granthaack/Defcon26Badge/pcb_files/BoardFootprintBottom.png

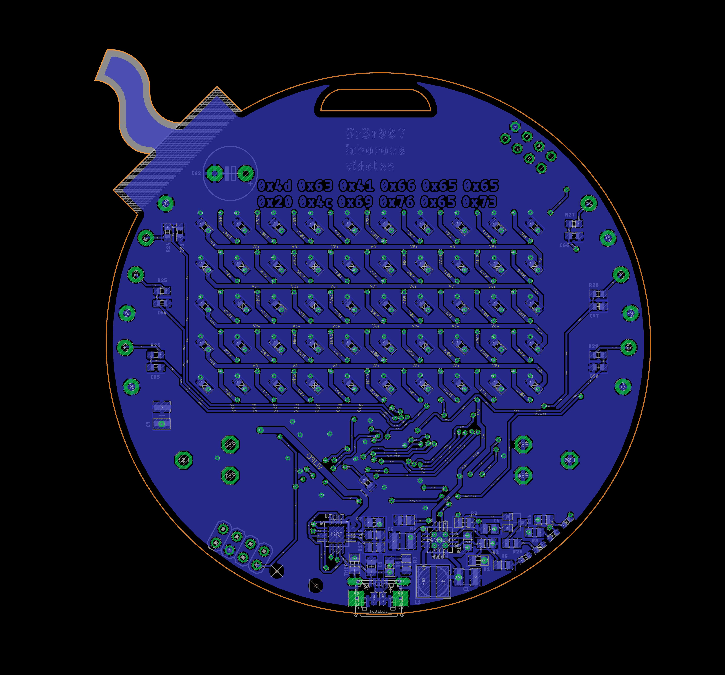
pcb_files/BoardFootprintBottom.png
