granthaack/Defcon26Badge/pcb_files/BoardFootprintTop.png

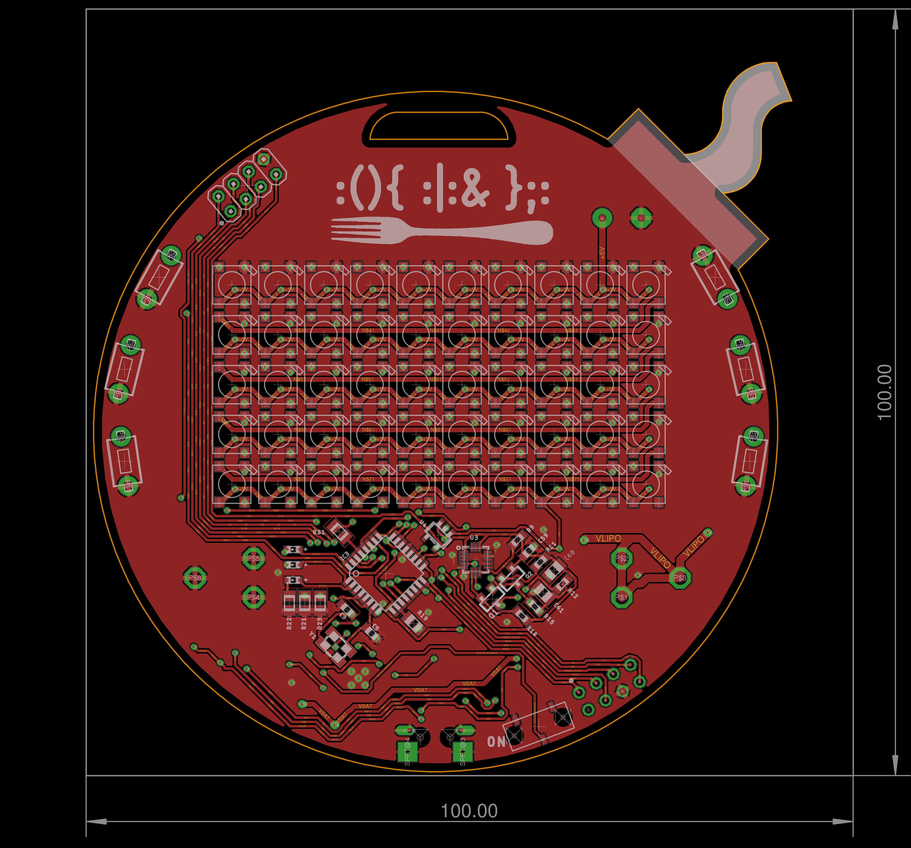
pcb_files/BoardFootprintTop.png
