granthaack/Defcon26Badge/pcb_files/footprint.png

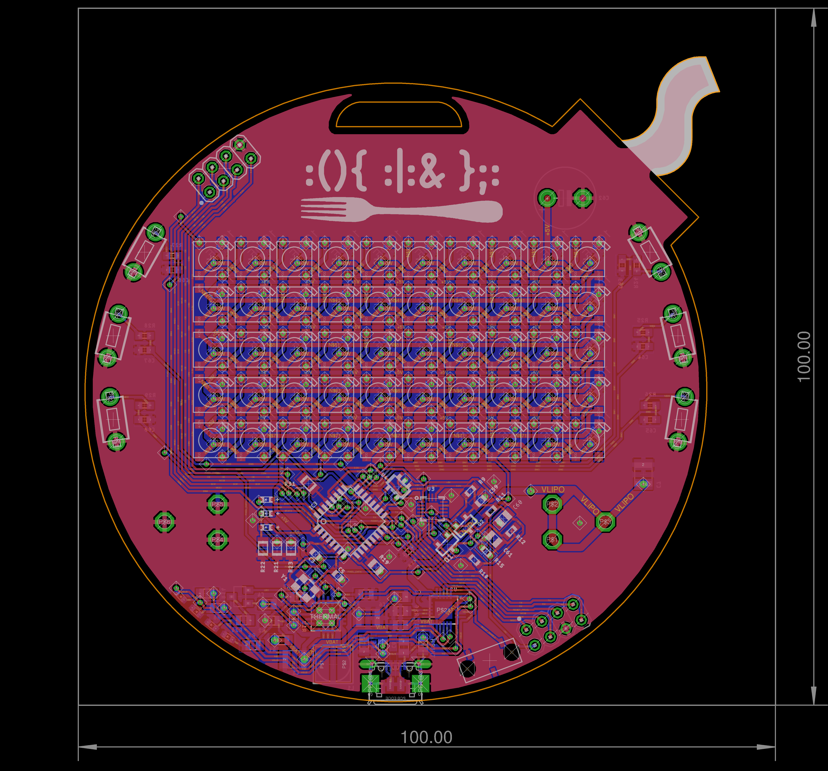
pcb_files/footprint.png
