granthaack/Defcon26Badge/pcb_files/schematic-highres.png

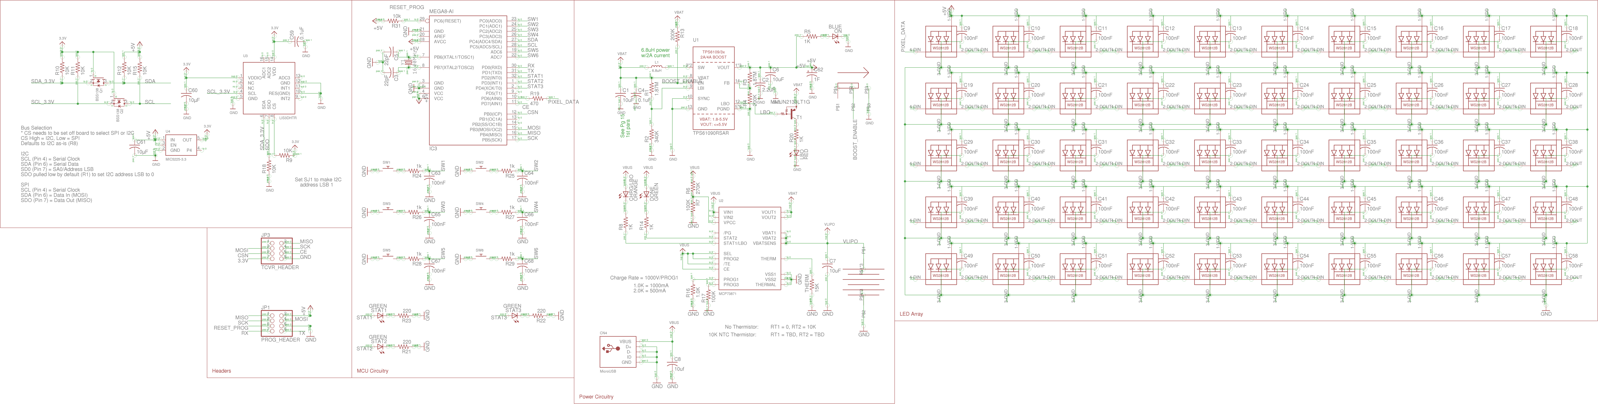
pcb_files/schematic-highres.png
