granthaack/Defcon26Badge/pcb_files/schematic.png

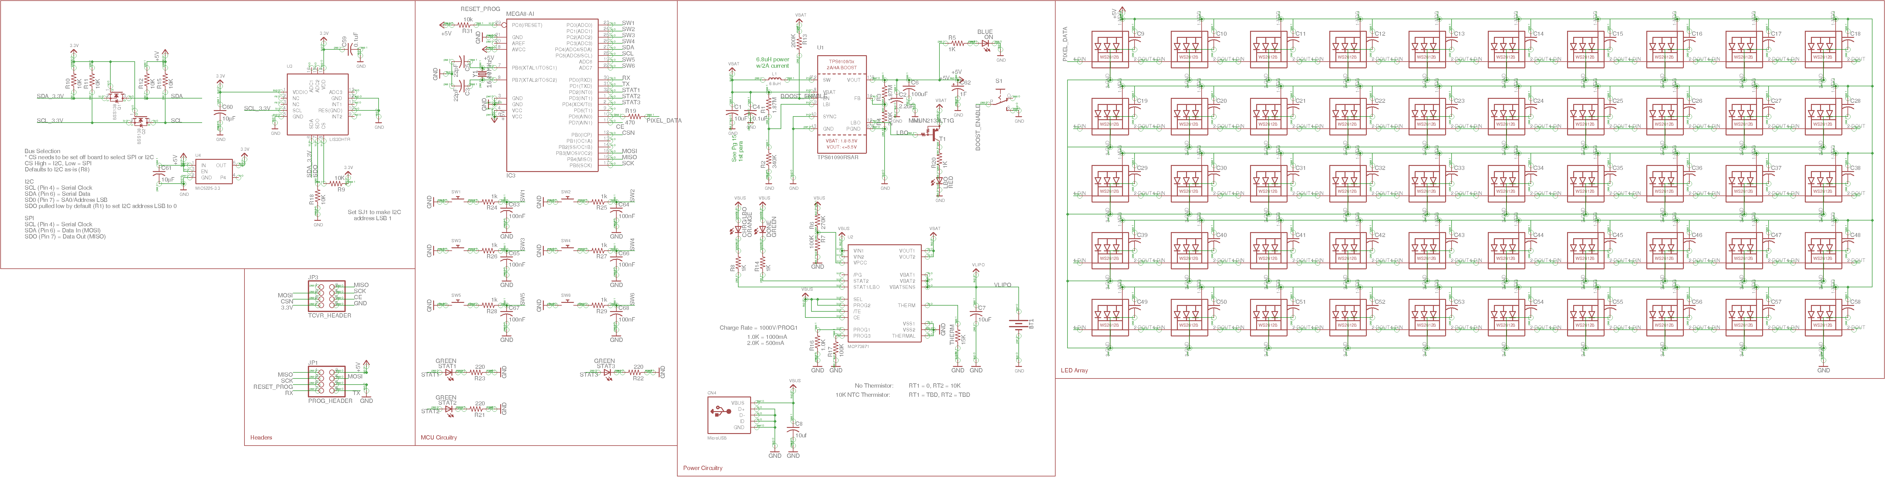
pcb_files/schematic.png
