granthaack/Defcon26Badge/pcb_files/badge.brd

## EAGLE design pcb_files/badge.brd (2018-06-25)

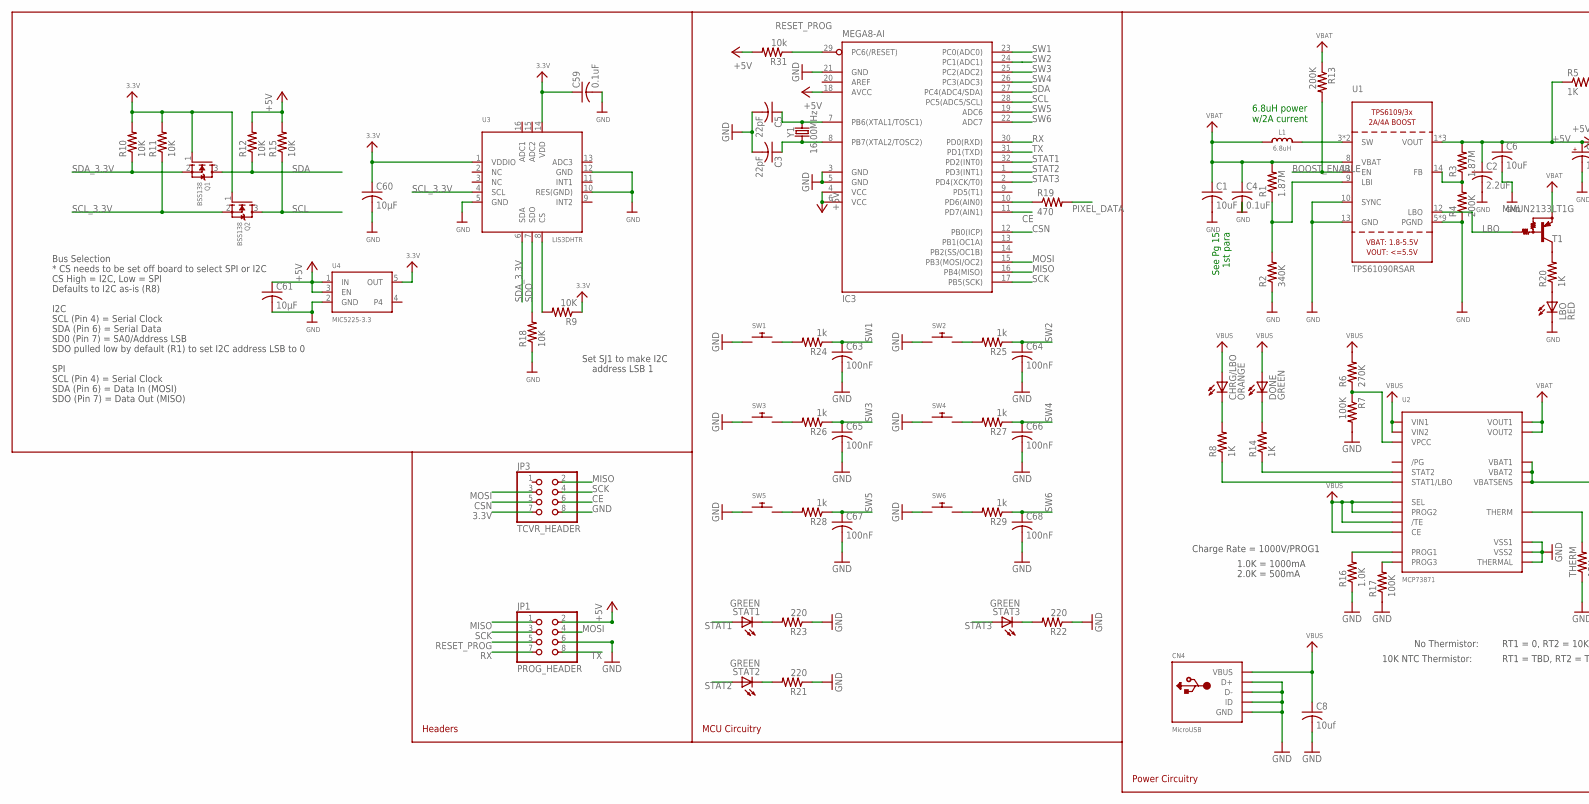
[picture p6: schematic badge.sch, part in row 1, column 1]

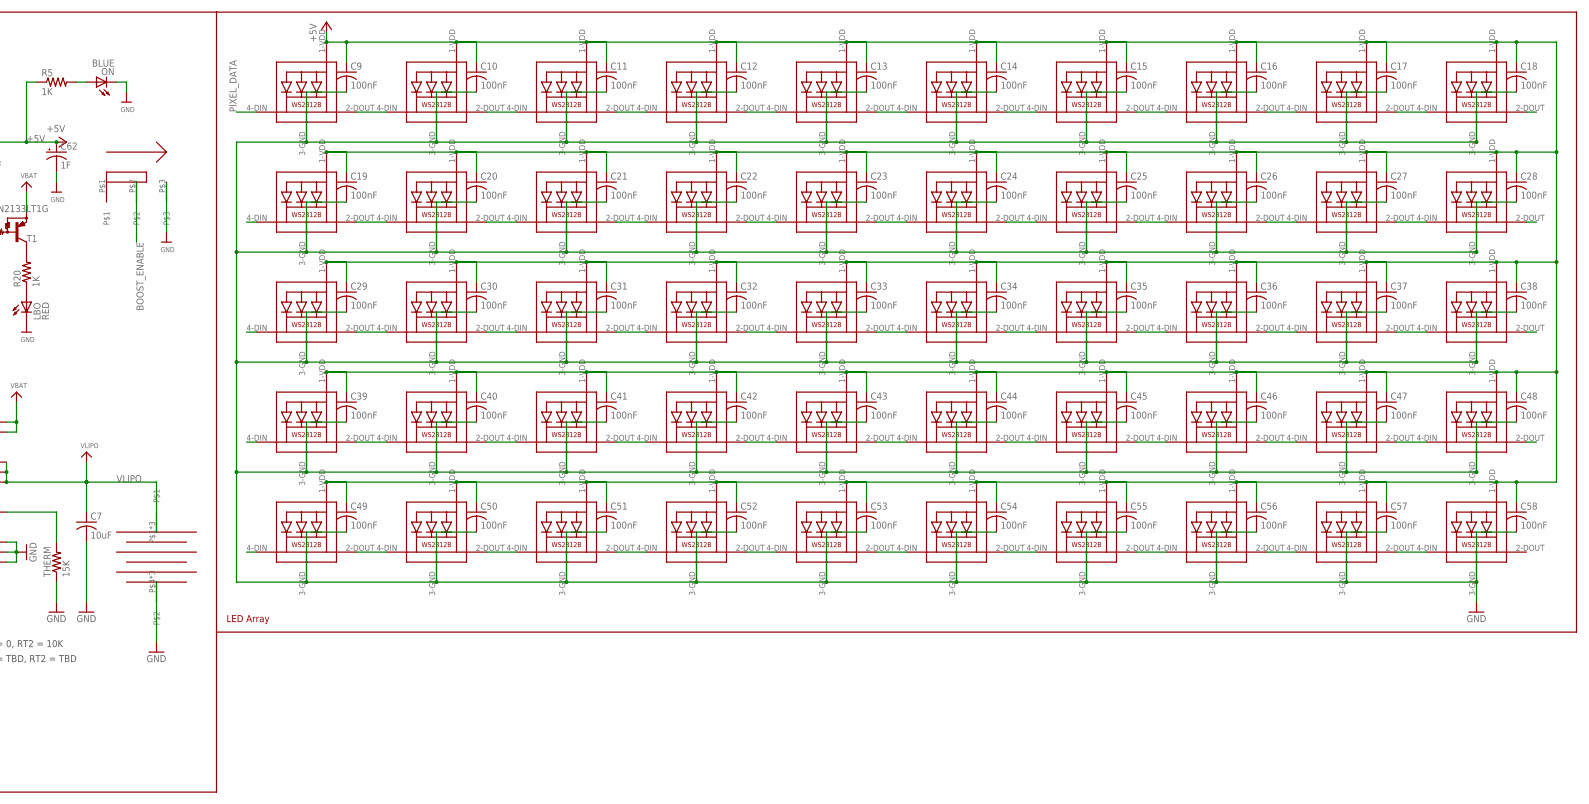
[picture p7: schematic badge.sch, part in row 1, column 2]

Parts:
C1, C6, C7: 10uF; C1210
C2: 2.2uF; C0805
C3, C5: 22pF; C0603
C4: 0.1uF; C0805
C8: 10uf; C0805
C9, C10, C11, C12, C13, C14, C15, C16, C17, C18, C19, C20, C21, C22, C23, C24, C25, C26, C27, C28, C29, C30, C31, C32, C33, C34, C35, C36, C37, C38, C39, C40, C41, C42, C43, C44, C45, C46, C47, C48, C49, C50, C51, C52, C53, C54, C55, C56, C57, C58, C63, C64, C65, C66, C67, C68: 100nF; C0603
C59: 0.1uF; C0603
C60, C61: 10µF; C0805
C62: 1F; E5-8,5
CHRG/LBO: ORANGE; ADAFRUIT_CHIPLED_0603
CN4: MicroUSB; 4UCONN_20329
DONE: GREEN; ADAFRUIT_CHIPLED_0603
IC3: MEGA8-AI; TQFP32-08
JP1: PROG_HEADER; 2X04
JP3: TCVR_HEADER; 2X04
L1: 6.8uH; INDUCTOR_5X5MM_TDK_VLC5045
LBO: RED; ADAFRUIT_CHIPLED_0603
LED1, LED2, LED3, LED4, LED5, LED6, LED7, LED8, LED9, LED10, LED11, LED12, LED13, LED14, LED15, LED16, LED17, LED18, LED19, LED20, LED21, LED22, LED23, LED24, LED25, LED26, LED27, LED28, LED29, LED30, LED31, LED32, LED33, LED34, LED35, LED36, LED37, LED38, LED39, LED40, LED41, LED42, LED43, LED44, LED45, LED46, LED47, LED48, LED49, LED50: WS2812B5050-NARROW; WS2812B-NARROW
ON: BLUE; ADAFRUIT_CHIPLED_0603
Q1, Q2: BSS138; SOT23-WIDE
R1, R3: 1.87M; R0805
R2: 340K; R0805
R4, R13: 200K; R0805
R5, R8, R14, R20: 1K; R0805
R6: 270K; R0805
R7, R17: 100K; R0805
R9, R10, R11, R12, R15, R18: 10K; R0603
R16: 1.0K; R0805
R19: 470; R0805
R21, R22, R23: 220; M0805
R24, R25, R26, R27, R28, R29: 1k; R0603
R31: 10k; M0805
STAT1, STAT2, STAT3: GREEN; ADAFRUIT_CHIPLED_0603
SW1, SW2, SW3, SW4, SW5, SW6: SWITCH_PUSHBUTTONEVQ-PE; TACT_PANA-EVQ
T1: MMUN2133LT1G; TRANSISTOR_SC59-BEC
THERM: 15K; R0805
U1: TPS61090RSAR; PVQFN-16
U2: MCP73871; QFN20_4MM
U3: LIS3DHTR; LGA16_3X3MM
U4: MIC5225-3.3; SOT23-5
U$17: CL-SB-12A-02T
U$22: 54_BATTERY_CLIP
Y1: 16.00MHz; CRYSTAL-SMD-3.2X2.5MM

Connections:
3.3V: C59.1, C60.1, JP3.7, Q1.1 (G), Q2.1 (G), R9.1, R10.2, R11.2, U3.1 (VDDIO), U3.14 (VDD), U4.5 (OUT)
+5V: C2.1, C6.1, C9.1, C10.1, C11.1, C12.1, C13.1, C14.1, C15.1, C16.1, C17.1, C18.1, C19.1, C20.1, C21.1, C22.1, C23.1, C24.1, C25.1, C26.1, C27.1, C28.1, C29.1, C30.1, C31.1, C32.1, C33.1, C34.1, C35.1, C36.1, C37.1, C38.1, C39.1, C40.1, C41.1, C42.1, C43.1, C44.1, C45.1, C46.1, C47.1, C48.1, C49.1, C50.1, C51.1, C52.1, C53.1, C54.1, C55.1, C56.1, C57.1, C58.1, C61.1, C62.+, IC3.4 (VCC), IC3.6 (VCC), IC3.18 (AVCC), JP1.2, LED1.1-VDD (VDD), LED2.1-VDD (VDD), LED3.1-VDD (VDD), LED4.1-VDD (VDD), LED5.1-VDD (VDD), LED6.1-VDD (VDD), LED7.1-VDD (VDD), LED8.1-VDD (VDD), LED9.1-VDD (VDD), LED10.1-VDD (VDD), LED11.1-VDD (VDD), LED12.1-VDD (VDD), LED13.1-VDD (VDD), LED14.1-VDD (VDD), LED15.1-VDD (VDD), LED16.1-VDD (VDD), LED17.1-VDD (VDD), LED18.1-VDD (VDD), LED19.1-VDD (VDD), LED20.1-VDD (VDD), LED21.1-VDD (VDD), LED22.1-VDD (VDD), LED23.1-VDD (VDD), LED24.1-VDD (VDD), LED25.1-VDD (VDD), LED26.1-VDD (VDD), LED27.1-VDD (VDD), LED28.1-VDD (VDD), LED29.1-VDD (VDD), LED30.1-VDD (VDD), LED31.1-VDD (VDD), LED32.1-VDD (VDD), LED33.1-VDD (VDD), LED34.1-VDD (VDD), LED35.1-VDD (VDD), LED36.1-VDD (VDD), LED37.1-VDD (VDD), LED38.1-VDD (VDD), LED39.1-VDD (VDD), LED40.1-VDD (VDD), LED41.1-VDD (VDD), LED42.1-VDD (VDD), LED43.1-VDD (VDD), LED44.1-VDD (VDD), LED45.1-VDD (VDD), LED46.1-VDD (VDD), LED47.1-VDD (VDD), LED48.1-VDD (VDD), LED49.1-VDD (VDD), LED50.1-VDD (VDD), R3.2, R5.1, R12.2, R15.2, R31.2, U1.1 (VOUT), U1.15 (VOUT), U1.16 (VOUT), U4.1 (IN), U4.3 (EN)
BOOST_ENABLE: R13.2, U1.11 (EN), U$17.P$2
CE: IC3.11 (PD7(AIN1)), JP3.6
CSN: IC3.12 (PB0(ICP)), JP3.5
GND: C1.2, C2.2, C3.2, C4.2, C5.2, C6.2, C7.2, C8.2, C9.2, C10.2, C11.2, C12.2, C13.2, C14.2, C15.2, C16.2, C17.2, C18.2, C19.2, C20.2, C21.2, C22.2, C23.2, C24.2, C25.2, C26.2, C27.2, C28.2, C29.2, C30.2, C31.2, C32.2, C33.2, C34.2, C35.2, C36.2, C37.2, C38.2, C39.2, C40.2, C41.2, C42.2, C43.2, C44.2, C45.2, C46.2, C47.2, C48.2, C49.2, C50.2, C51.2, C52.2, C53.2, C54.2, C55.2, C56.2, C57.2, C58.2, C59.2, C60.2, C61.2, C62.-, C63.2, C64.2, C65.2, C66.2, C67.2, C68.2, CN4.BASE@1 (GND), CN4.BASE@2 (GND), CN4.D+, CN4.D-, CN4.GND, CN4.ID, CN4.SPRT@1 (GND), CN4.SPRT@2 (GND), CN4.SPRT@3 (GND), CN4.SPRT@4 (GND), IC3.3 (GND), IC3.5 (GND), IC3.21 (GND), JP1.6, JP3.8, LBO.C, LED1.3-GND (GND), LED2.3-GND (GND), LED3.3-GND (GND), LED4.3-GND (GND), LED5.3-GND (GND), LED6.3-GND (GND), LED7.3-GND (GND), LED8.3-GND (GND), LED9.3-GND (GND), LED10.3-GND (GND), LED11.3-GND (GND), LED12.3-GND (GND), LED13.3-GND (GND), LED14.3-GND (GND), LED15.3-GND (GND), LED16.3-GND (GND), LED17.3-GND (GND), LED18.3-GND (GND), LED19.3-GND (GND), LED20.3-GND (GND), LED21.3-GND (GND), LED22.3-GND (GND), LED23.3-GND (GND), LED24.3-GND (GND), LED25.3-GND (GND), LED26.3-GND (GND), LED27.3-GND (GND), LED28.3-GND (GND), LED29.3-GND (GND), LED30.3-GND (GND), LED31.3-GND (GND), LED32.3-GND (GND), LED33.3-GND (GND), LED34.3-GND (GND), LED35.3-GND (GND), LED36.3-GND (GND), LED37.3-GND (GND), LED38.3-GND (GND), LED39.3-GND (GND), LED40.3-GND (GND), LED41.3-GND (GND), LED42.3-GND (GND), LED43.3-GND (GND), LED44.3-GND (GND), LED45.3-GND (GND), LED46.3-GND (GND), LED47.3-GND (GND), LED48.3-GND (GND), LED49.3-GND (GND), LED50.3-GND (GND), ON.C, R2.1, R4.1, R7.2, R16.1, R17.1, R18.1, R21.1, R22.1, R23.1, SW1.P$1, SW2.P$1, SW3.P$1, SW4.P$1, SW5.P$1, SW6.P$1, THERM.1, U1.5 (PGND), U1.6 (PGND), U1.7 (PGND), U1.10 (SYNC), U1.13 (GND), U1.P$18 (PGND), U1.P$19 (PGND), U1.P$20 (PGND), U1.P$21 (PGND), U1.P$22 (PGND), U1.THERMAL (PGND), U2.P$10 (VSS1), U2.P$11 (VSS2), U2.P$21 (THERMAL), U3.5 (GND), U3.10 (RES(GND)), U3.12 (GND), U4.2 (GND), U$17.P$3, U$22.P$4, U$22.P$5, U$22.P$6
LBO: T1.B, U1.12 (LBO)
MISO: IC3.16 (PB4(MISO)), JP1.1, JP3.2
MOSI: IC3.15 (PB3(MOSI/OC2)), JP1.4, JP3.3
unnamed: L1.P$2 (2), U1.3 (SW), U1.4 (SW)
unnamed: LBO.A, R20.1
unnamed: R1.1, R2.2, U1.9 (LBI)
unnamed: ON.A, R5.2
unnamed: R3.1, R4.2, U1.14 (FB)
unnamed: R20.2, T1.C
unnamed: R6.1, R7.1, U2.P$2 (VPCC)
unnamed: DONE.C, R14.2
unnamed: R14.1, U2.P$7 (STAT2)
unnamed: THERM.2, U2.P$5 (THERM)
unnamed: R8.1, U2.P$8 (STAT1/LBO)
unnamed: CHRG/LBO.C, R8.2
unnamed: R17.2, U2.P$12 (PROG3)
unnamed: C5.1, IC3.7 (PB6(XTAL1/TOSC1)), Y1.3 (2)
unnamed: C3.1, IC3.8 (PB7(XTAL2/TOSC2)), Y1.1
unnamed: R16.2, U2.P$13 (PROG1)
unnamed: LED2.2-DOUT (DO), LED3.4-DIN (DI)
unnamed: R9.2, U3.8 (CS)
unnamed: R21.2, STAT2.C
unnamed: R22.2, STAT3.C
unnamed: R23.2, STAT1.C
unnamed: R24.2, SW1.P$2
unnamed: LED1.2-DOUT (DO), LED2.4-DIN (DI)
unnamed: LED3.2-DOUT (DO), LED4.4-DIN (DI)
unnamed: LED4.2-DOUT (DO), LED5.4-DIN (DI)
unnamed: LED5.2-DOUT (DO), LED6.4-DIN (DI)
unnamed: R26.2, SW3.P$2
unnamed: R28.2, SW5.P$2
unnamed: R29.2, SW6.P$2
unnamed: R27.2, SW4.P$2
unnamed: R25.2, SW2.P$2
unnamed: LED6.2-DOUT (DO), LED7.4-DIN (DI)
unnamed: LED7.2-DOUT (DO), LED8.4-DIN (DI)
unnamed: LED8.2-DOUT (DO), LED9.4-DIN (DI)
unnamed: LED9.2-DOUT (DO), LED10.4-DIN (DI)
unnamed: LED10.2-DOUT (DO), LED11.4-DIN (DI)
unnamed: LED11.2-DOUT (DO), LED12.4-DIN (DI)
unnamed: LED12.2-DOUT (DO), LED13.4-DIN (DI)
unnamed: LED13.2-DOUT (DO), LED14.4-DIN (DI)
unnamed: LED14.2-DOUT (DO), LED15.4-DIN (DI)
unnamed: LED15.2-DOUT (DO), LED16.4-DIN (DI)
unnamed: LED16.2-DOUT (DO), LED17.4-DIN (DI)
unnamed: LED17.2-DOUT (DO), LED18.4-DIN (DI)
unnamed: LED18.2-DOUT (DO), LED19.4-DIN (DI)
unnamed: LED19.2-DOUT (DO), LED20.4-DIN (DI)
unnamed: LED20.2-DOUT (DO), LED21.4-DIN (DI)
unnamed: LED21.2-DOUT (DO), LED22.4-DIN (DI)
unnamed: LED22.2-DOUT (DO), LED23.4-DIN (DI)
unnamed: LED23.2-DOUT (DO), LED24.4-DIN (DI)
unnamed: LED24.2-DOUT (DO), LED25.4-DIN (DI)
unnamed: LED25.2-DOUT (DO), LED26.4-DIN (DI)
unnamed: LED26.2-DOUT (DO), LED27.4-DIN (DI)
unnamed: LED27.2-DOUT (DO), LED28.4-DIN (DI)
unnamed: LED28.2-DOUT (DO), LED29.4-DIN (DI)
unnamed: LED29.2-DOUT (DO), LED30.4-DIN (DI)
unnamed: LED30.2-DOUT (DO), LED31.4-DIN (DI)
unnamed: LED31.2-DOUT (DO), LED32.4-DIN (DI)
unnamed: LED32.2-DOUT (DO), LED33.4-DIN (DI)
unnamed: LED33.2-DOUT (DO), LED34.4-DIN (DI)
unnamed: LED34.2-DOUT (DO), LED35.4-DIN (DI)
unnamed: LED35.2-DOUT (DO), LED36.4-DIN (DI)
unnamed: LED36.2-DOUT (DO), LED37.4-DIN (DI)
unnamed: LED37.2-DOUT (DO), LED38.4-DIN (DI)
unnamed: LED38.2-DOUT (DO), LED39.4-DIN (DI)
unnamed: LED39.2-DOUT (DO), LED40.4-DIN (DI)
unnamed: LED40.2-DOUT (DO), LED41.4-DIN (DI)
unnamed: LED41.2-DOUT (DO), LED42.4-DIN (DI)
unnamed: LED42.2-DOUT (DO), LED43.4-DIN (DI)
unnamed: LED43.2-DOUT (DO), LED44.4-DIN (DI)
unnamed: LED44.2-DOUT (DO), LED45.4-DIN (DI)
unnamed: LED45.2-DOUT (DO), LED46.4-DIN (DI)
unnamed: LED46.2-DOUT (DO), LED47.4-DIN (DI)
unnamed: LED47.2-DOUT (DO), LED48.4-DIN (DI)
unnamed: LED48.2-DOUT (DO), LED49.4-DIN (DI)
unnamed: LED49.2-DOUT (DO), LED50.4-DIN (DI)
NEO-DOUT: IC3.10 (PD6(AIN0)), R19.1
PIXEL_DATA: LED1.4-DIN (DI), R19.2
RESET_PROG: IC3.29 (PC6(/RESET)), JP1.5, R31.1
RX: IC3.30 (PD0(RXD)), JP1.7
SCK: IC3.17 (PB5(SCK)), JP1.3, JP3.4
SCL: IC3.28 (PC5(ADC5/SCL)), Q2.3 (D), R15.1
SCL_3.3V: Q2.2 (S), R11.1, U3.4 (SCL)
SDA: IC3.27 (PC4(ADC4/SDA)), Q1.3 (D), R12.1
SDA_3.3V: Q1.2 (S), R10.1, U3.6 (SDA)
SDO: R18.2, U3.7 (SDO)
STAT1: IC3.32 (PD2(INT0)), STAT1.A
STAT2: IC3.1 (PD3(INT1)), STAT2.A
STAT3: IC3.2 (PD4(XCK/T0)), STAT3.A
SW1: C63.1, IC3.23 (PC0(ADC0)), R24.1
SW2: C64.1, IC3.24 (PC1(ADC1)), R25.1
SW3: C65.1, IC3.25 (PC2(ADC2)), R26.1
SW4: C66.1, IC3.26 (PC3(ADC3)), R27.1
SW5: C67.1, IC3.19 (ADC6), R28.1
SW6: C68.1, IC3.22 (ADC7), R29.1
TX: IC3.31 (PD1(TXD)), JP1.8
VBAT: C1.1, C4.1, L1.P$1 (1), R1.2, R13.1, T1.E, U1.8 (VBAT), U2.P$1 (VOUT1), U2.P$20 (VOUT2)
VBUS: C8.1, CHRG/LBO.A, CN4.VBUS, DONE.A, R6.2, U2.P$3 (SEL), U2.P$4 (PROG2), U2.P$9 (/TE), U2.P$17 (CE), U2.P$18 (VIN1), U2.P$19 (VIN2)
VLIPO: C7.1, U2.P$14 (VBAT1), U2.P$15 (VBAT2), U2.P$16 (VBATSENS), U$22.P$1, U$22.P$2, U$22.P$3

Notes on the sheet:
See Pg 15 1st para
6.8uH power w/2A current
Charge Rate = 1000V/PROG1
1.0K = 1000mA
2.0K = 500mA
No Thermistor:
10K NTC Thermistor:
RT1 = 0, RT2 = 10K
RT1 = TBD, RT2 = TBD
I2C
SCL (Pin 4) = Serial Clock
SDA (Pin 6) = Serial Data
SD0 (Pin 7) = SA0/Address LSB
* CS needs to be set off board to select SPI or I2C
CS High = I2C, Low = SPI
Defaults to I2C as-is (R8)
SDO pulled low by default (R1) to set I2C address LSB to 0
Bus Selection
SPI
SDA (Pin 6) = Data In (MOSI)
SDO (Pin 7) = Data Out (MISO)
Set SJ1 to make I2C
address LSB 1
LED Array
Power Circuitry
MCU Circuitry
Headers

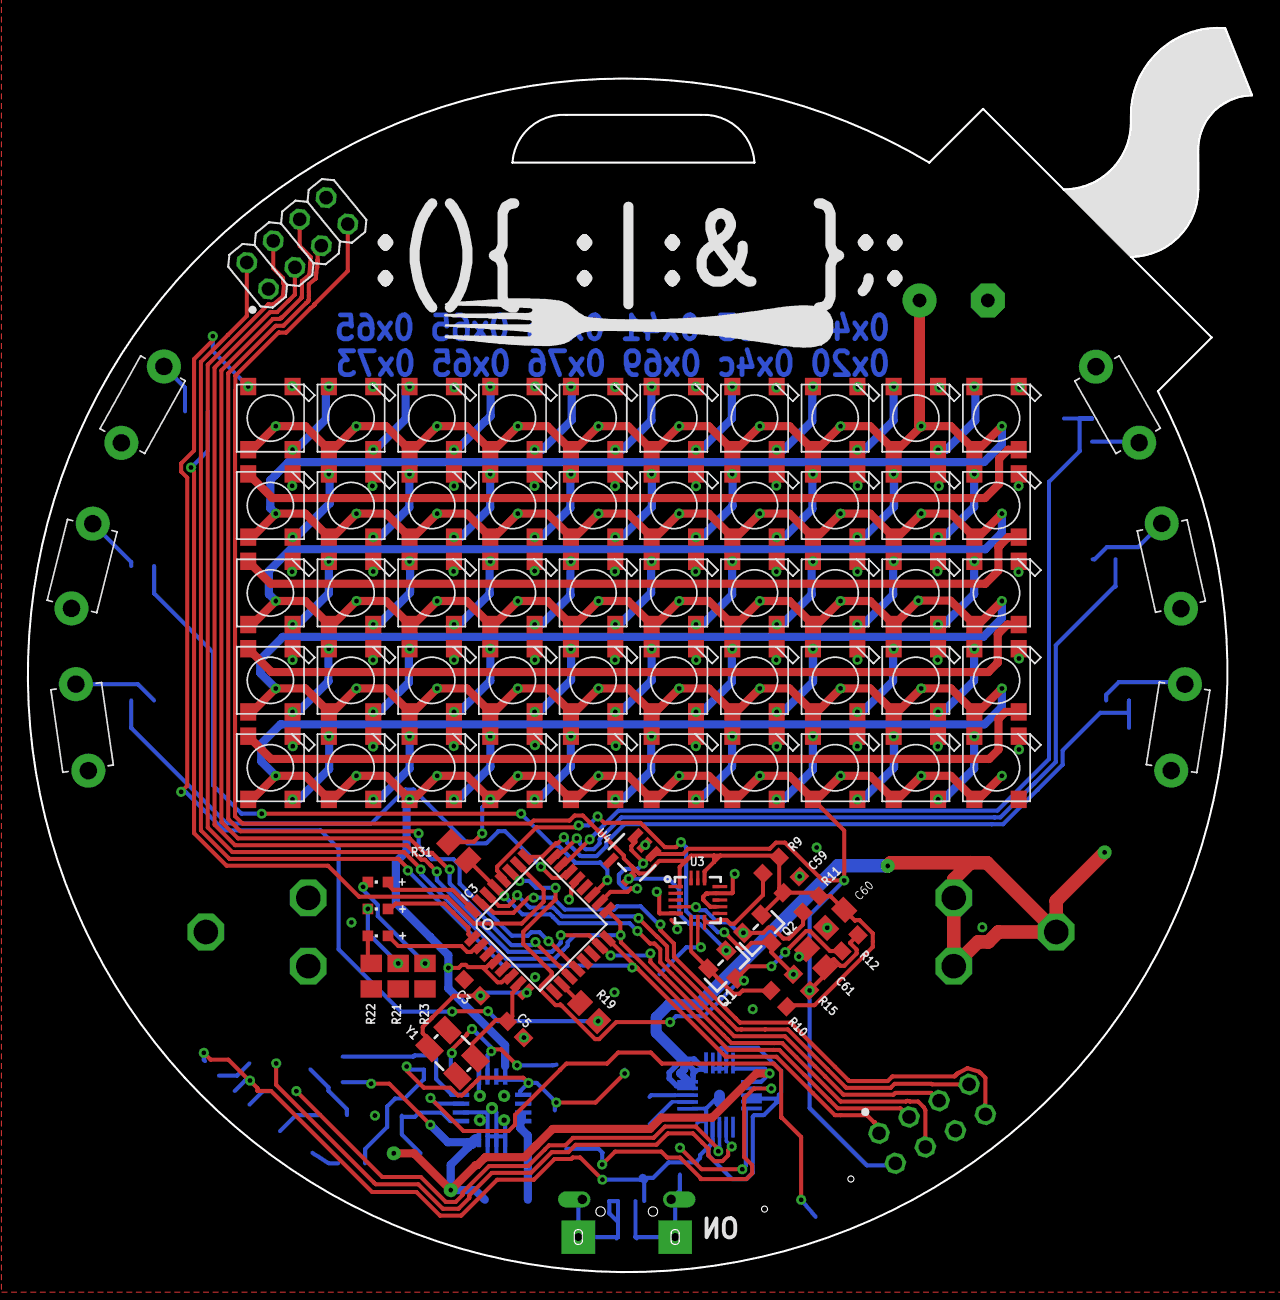
[picture p8: board badge.brd from above]

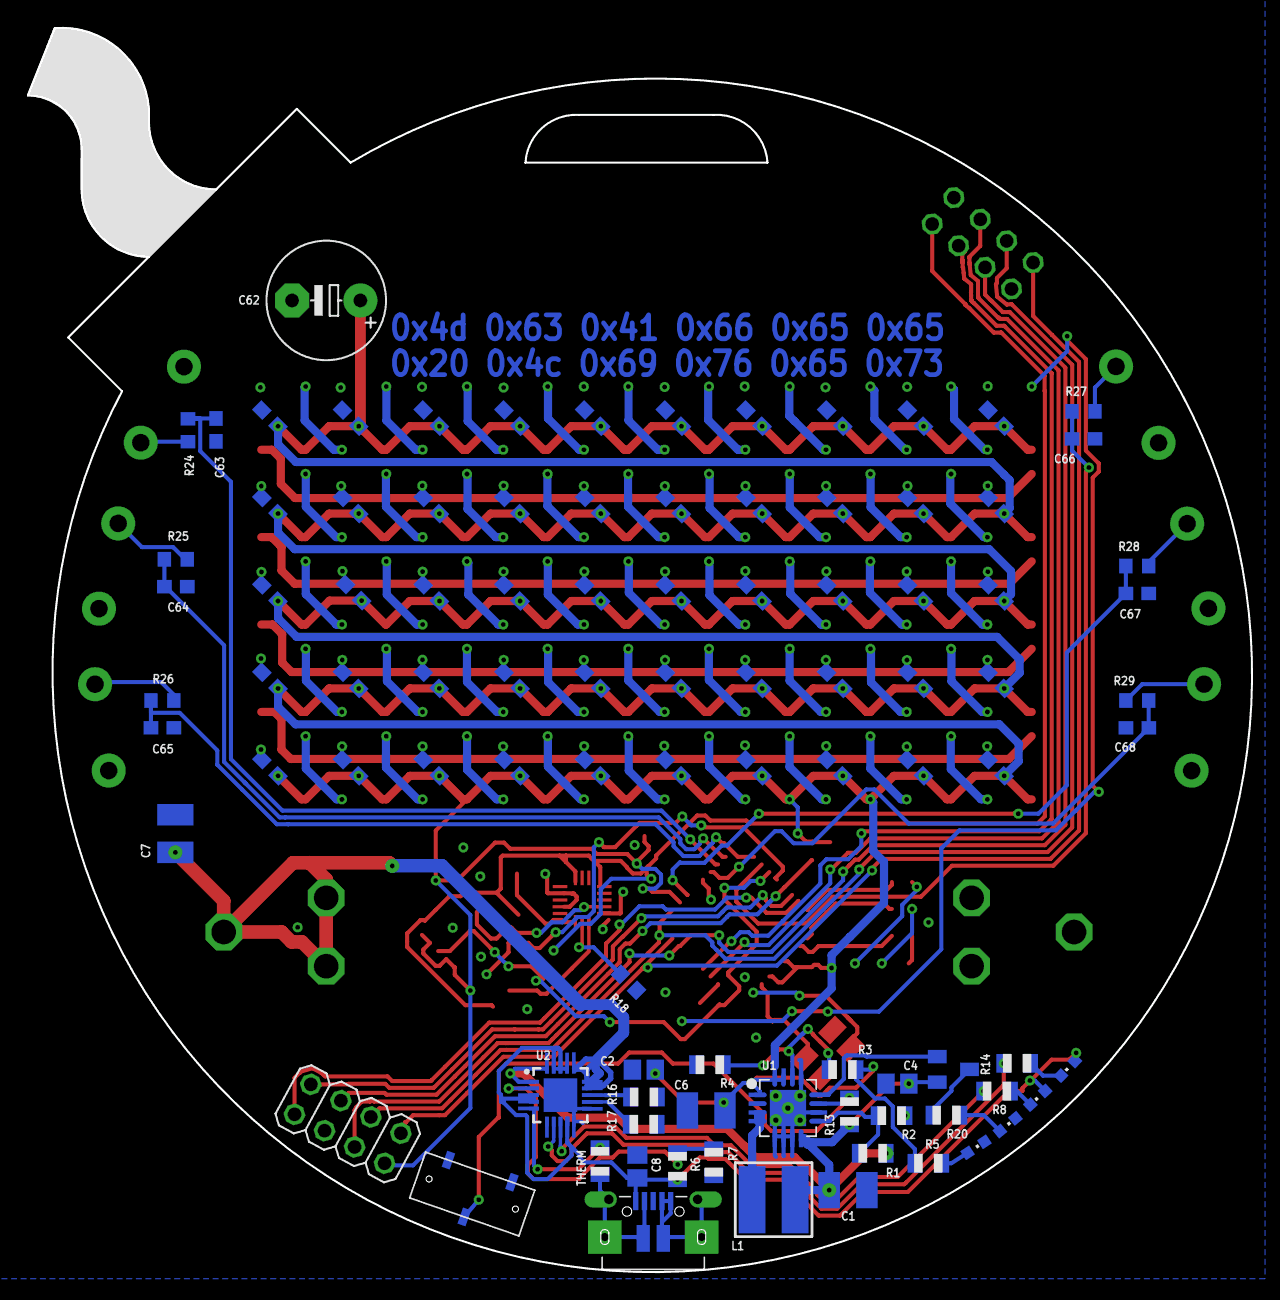
[picture p9: board badge.brd from below]

Board: 2 copper layers, 91.0 x 92.5 mm, 177 parts (95 on the bottom side), 107 nets.
