granthaack/Defcon26Badge/(commit log)

2018-06-03 Worked on badge shape
    [badge.brd]
2018-06-04 Added power management circuitry and the MCU
    [badge.brd]
2018-06-04 Cut down the LEDs to 50 and added filter caps for each
    [badge.brd, badge.sch]
2018-06-04 Added accelerometer circuitry
    [badge.brd, badge.sch]
2018-06-11 Added switches, status lights, RX/TX Headers
    [badge.brd, badge.sch]
2018-06-13 -wired all the pixels -cleaned up the schematic
    [badge.brd, badge.sch]
2018-06-13 haha forget to save fuck me
    [badge.brd, badge.sch]
2018-06-13 small silkscreen changes
    [badge.brd, badge.sch]
2018-06-18 Routed all the traces and performed a cursory DRC
    [badge.brd, badge.sch]
2018-06-19 cleaned up the screenprinting
    [badge.brd]
2018-06-20 generated a BOM and started to add parts to it on digikey
    [badge.brd, badge.sch, badge_bom.csv]
2018-06-23 cleaned up the traces and completed the BOM
    [badge.brd]
2018-06-25 ready for production
    [badge.brd, badge.sch, badge_bom.csv]
2018-07-21 moved pcb files to a new folder
    [badge.brd, badge.sch, badge_bom.csv]
2018-07-21 initialized the arduino project
2018-07-21 Fixed bugs and optimized
    [defcon26.ino, displays.h]
